FranjelisLuciano/Franjelis_Luciano_PLC4UNI/Tarea 6/4.Etiquetas/imagen.png

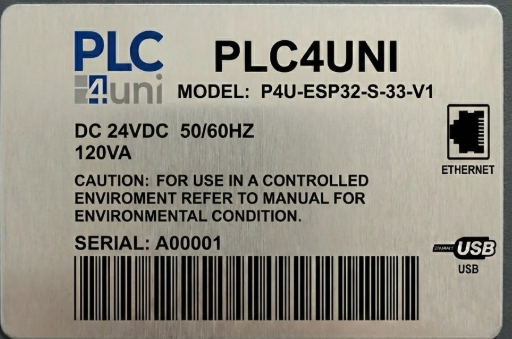
Tarea 6/4.Etiquetas/imagen.png
