FranjelisLuciano/Franjelis_Luciano_PLC4UNI/Tarea 6/4.Etiquetas/Informaciones de conexiones.png

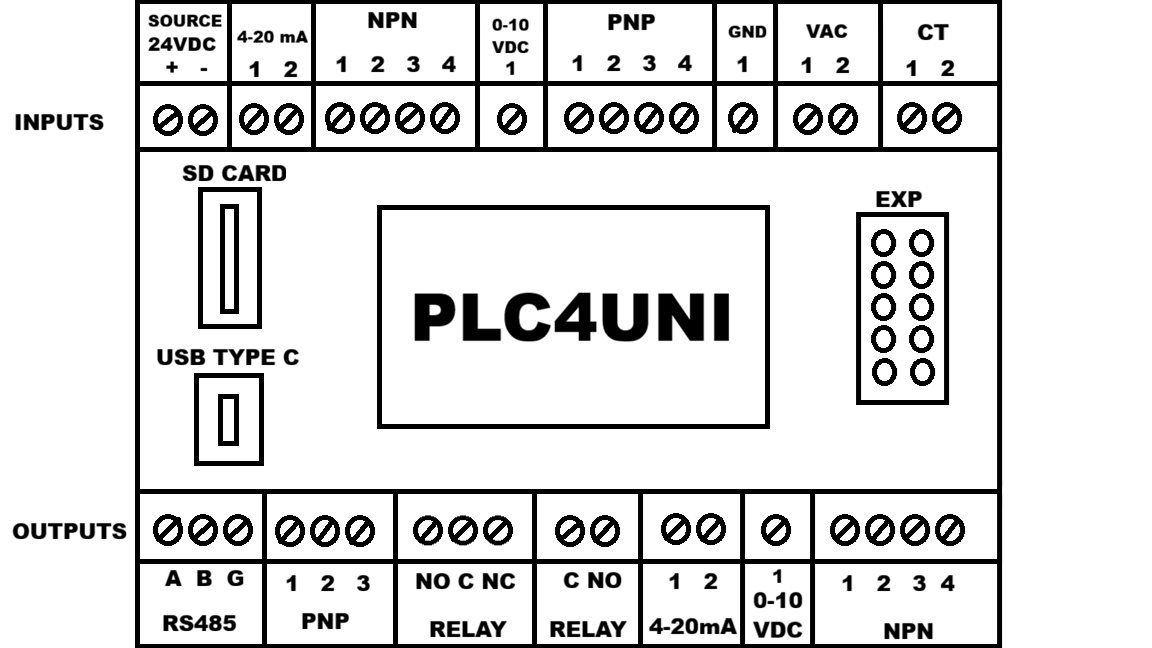
Tarea 6/4.Etiquetas/Informaciones de conexiones.png
