FranjelisLuciano/Franjelis_Luciano_PLC4UNI/Tarea 6/4.Etiquetas/Información de conexiones .jpg

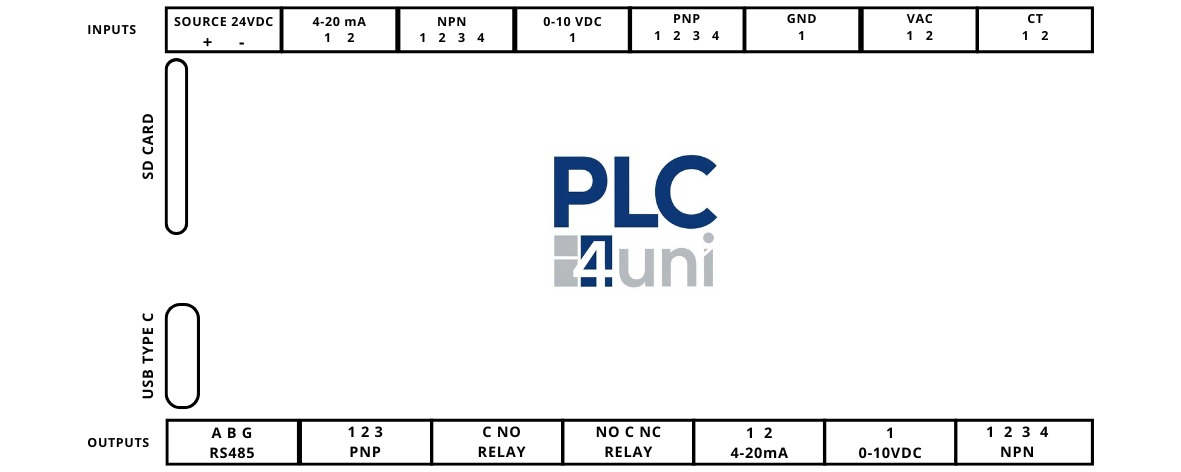
Tarea 6/4.Etiquetas/Información de conexiones .jpg
