FranjelisLuciano/Franjelis_Luciano_PLC4UNI/Tarea 6/Render/Render.png

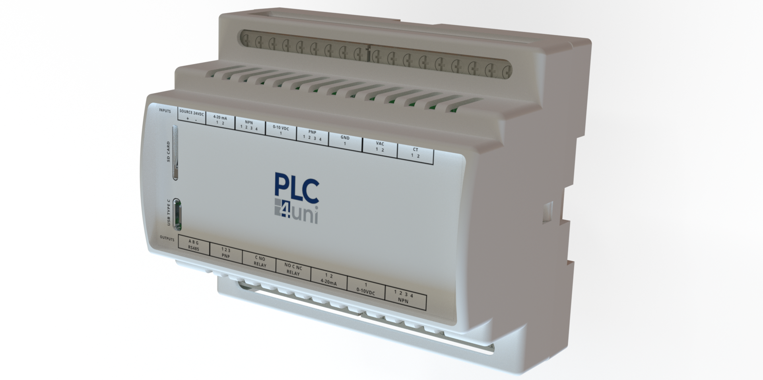
Tarea 6/Render/Render.png
