FranjelisLuciano/Franjelis_Luciano_PLC4UNI/Tarea 6/1.Ensamble en 3D/PLC4uni Ensamble.FCStd

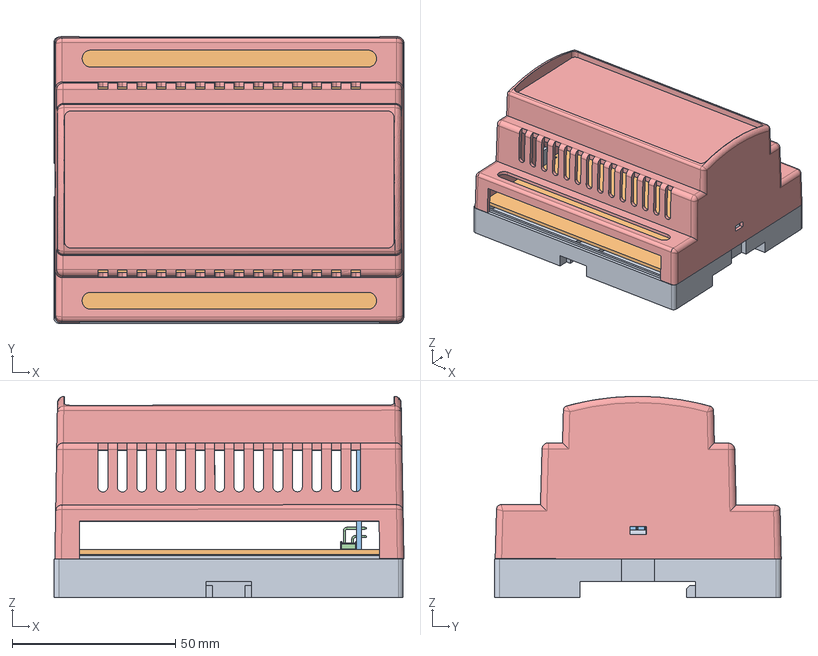
[picture p33: CAD file, 2025-12-03]
Tarea 6/1.Ensamble en 3D/PLC4uni Ensamble.FCStd
107.2 x 87.8 x 61.7 mm
PLC–4–UNI–209 Franjelis L._001
PLC4uni PCB_001
PLC4uni PCB_Vertical_001
2x5 male PIn Header Angle_001
PLC Part-1_001
