FranjelisLuciano/Franjelis_Luciano_PLC4UNI/Tarea 6/1.Ensamble en 3D/Ensamble PCB Vertical.STEP

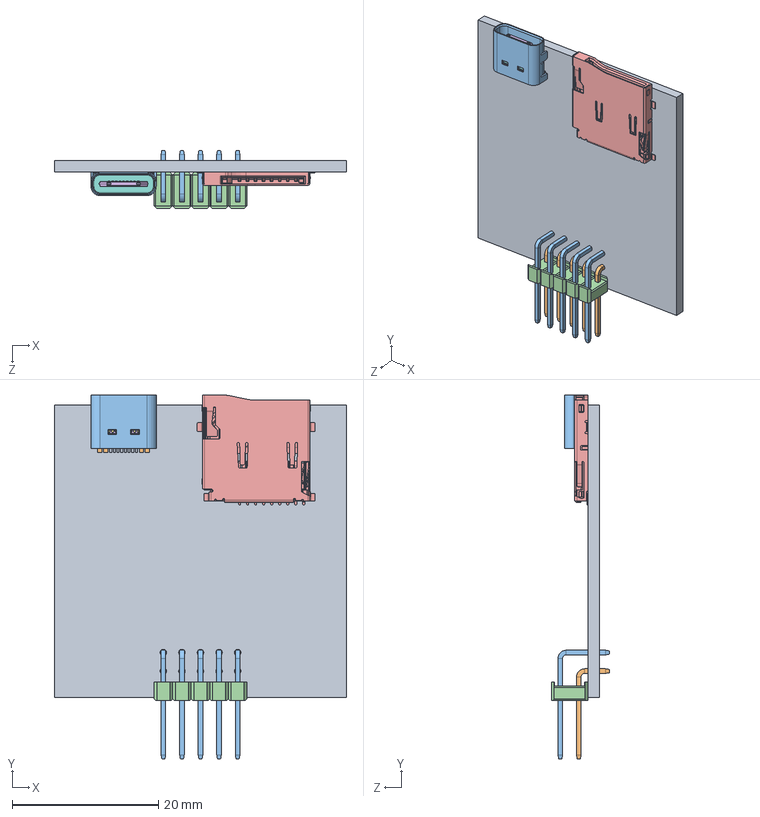
[picture p34: CAD file, 2025-12-03]
Tarea 6/1.Ensamble en 3D/Ensamble PCB Vertical.STEP
40.0 x 49.9 x 8.00 mm
PCB Vertical
2x5 Male Pin Header Angle
Same_Sky_MSD-4-A
USB Type C Port (SMD Type) (1)[1]
