FranjelisLuciano/Franjelis_Luciano_PLC4UNI/Tarea  4/PCB Vertical.DXF

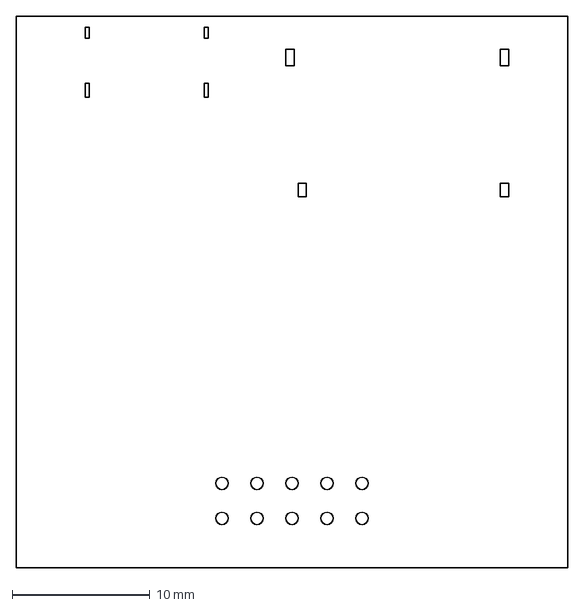
[picture p35: CAD file, 2025-12-03]
Tarea 4/PCB Vertical.DXF
40.0 x 40.0 mm
