FranjelisLuciano/Franjelis_Luciano_PLC4UNI/Tarea 3/DXF/Modelo 1/DXF de Freecad/PLC–4–UNI–209 Franjelis L.-Cuerpo001Fillet.dxf

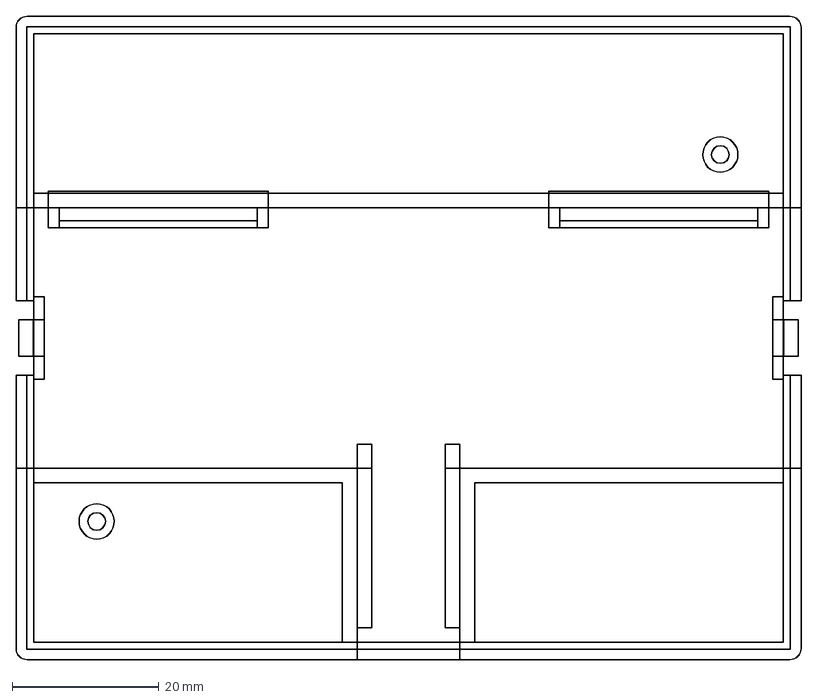
[picture p36: CAD file, 2025-10-09]
Tarea 3/DXF/Modelo 1/DXF de Freecad/PLC–4–UNI–209 Franjelis L.-Cuerpo001Fillet.dxf
107.0 x 87.7 mm
