FranjelisLuciano/Franjelis_Luciano_PLC4UNI/Tarea 6/2.Conector USB y SD Card/Same_Sky_MSD-4-A.step

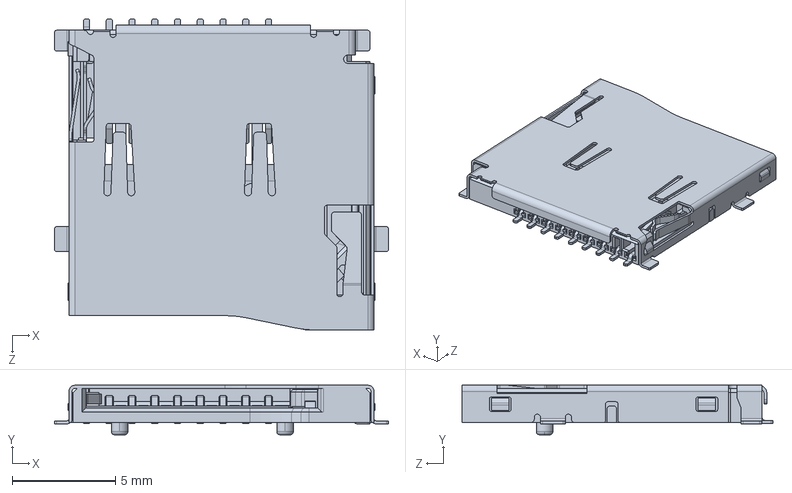
[picture p37: CAD file, 2025-12-03]
Tarea 6/2.Conector USB y SD Card/Same_Sky_MSD-4-A.step
16.1 x 2.40 x 15.0 mm
