FranjelisLuciano/Franjelis_Luciano_PLC4UNI/Tarea2_/Videos explicativos/Diseños 2.2/Diseños en Freecad/PLC–4–UNI–208 Franjelis L..FCStd

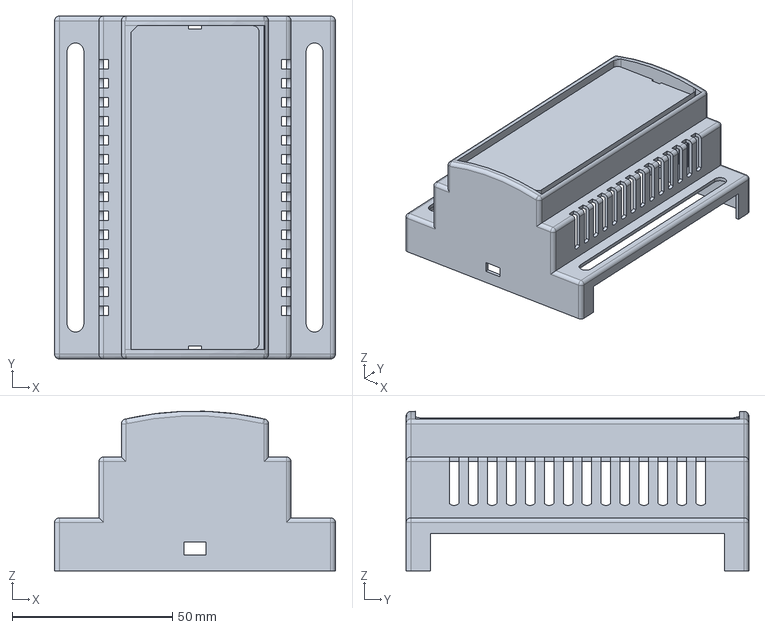
[picture p38: CAD file, 2025-10-02]
Tarea2_/Videos explicativos/Diseños 2.2/Diseños en Freecad/PLC–4–UNI–208 Franjelis L..FCStd
87.7 x 107.0 x 49.8 mm
