FranjelisLuciano/Franjelis_Luciano_PLC4UNI/Tarea  4/2x5 Male Pin Header Angle.STEP

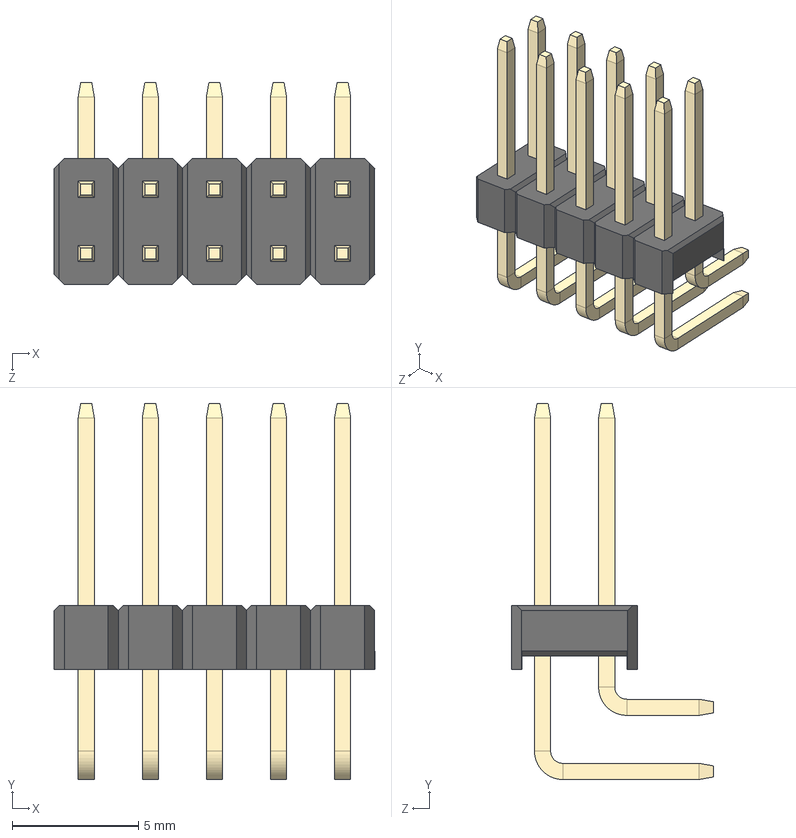
[picture p39: CAD file, 2025-12-03]
Tarea 4/2x5 Male Pin Header Angle.STEP
12.7 x 14.9 x 8.00 mm
