FranjelisLuciano/Franjelis_Luciano_PLC4UNI/Tarea 3/DXF/Modelo 1/DXF de Freecad/PLC–4–UNI–208 Franjelis L.-Body001Pad007.dxf

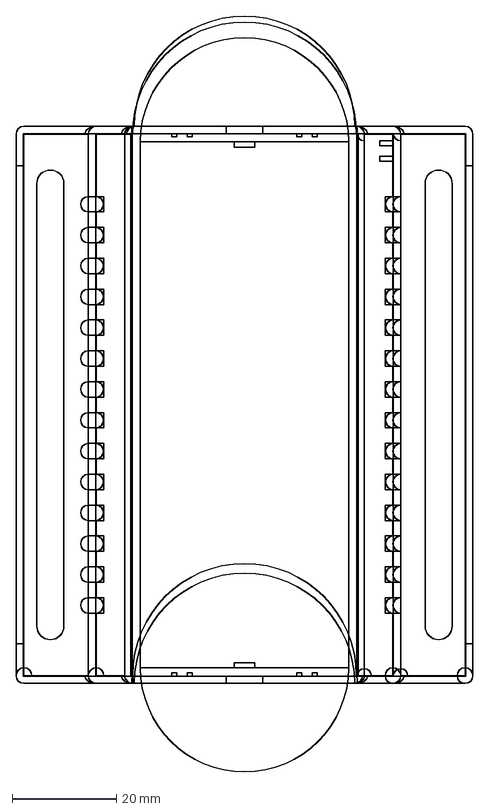
[picture p40: CAD file, 2025-10-09]
Tarea 3/DXF/Modelo 1/DXF de Freecad/PLC–4–UNI–208 Franjelis L.-Body001Pad007.dxf
87.7 x 145.2 mm
