FranjelisLuciano/Franjelis_Luciano_PLC4UNI/Tarea 6/2.Conector USB y SD Card/USB Type C Port (SMD Type) (1)[1].STEP

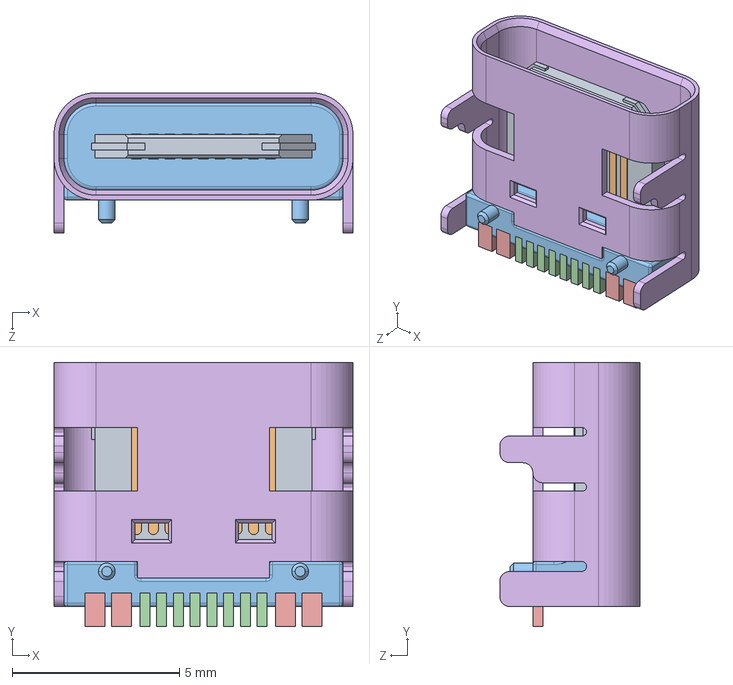
[picture p41: CAD file, 2025-12-03]
Tarea 6/2.Conector USB y SD Card/USB Type C Port (SMD Type) (1)[1].STEP
8.94 x 7.90 x 4.20 mm
