FranjelisLuciano/Franjelis_Luciano_PLC4UNI/Tarea2_/Videos explicativos/Diseños 2.2/Diseños en Freecad/PLC–4–UNI–209 Franjelis L..FCStd

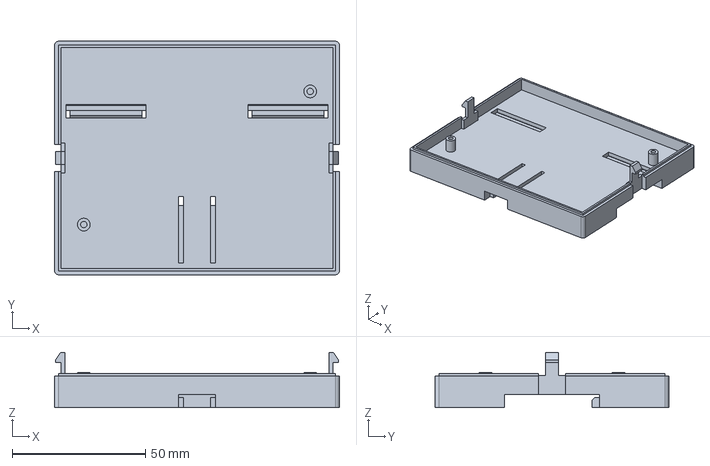
[picture p42: CAD file, 2025-10-02]
Tarea2_/Videos explicativos/Diseños 2.2/Diseños en Freecad/PLC–4–UNI–209 Franjelis L..FCStd
107.0 x 87.7 x 20.8 mm
