FranjelisLuciano/Franjelis_Luciano_PLC4UNI/DIAGRAMAS DE BORRADOR/Proyectoplc4unidiagramas/Proyectoplc4unidiagramas/OUT-NPN-1.kicad_sch

## KiCad design DIAGRAMAS DE BORRADOR/Proyectoplc4unidiagramas/Proyectoplc4unidiagramas/OUT-NPN-1.kicad_sch (2025-11-09)

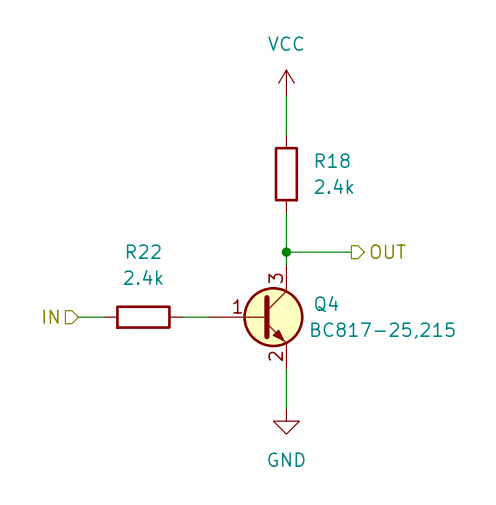
[picture p65: schematic OUT-NPN-1.kicad_sch]

Parts:
Q4: BFN26; SOT-23; Part number BC817-25,215
R18, R22: 2.4k; R_0603_1608Metric

Connections:
GND: Q4.2 (E)
IN: R22.1
unnamed: Q4.1 (B), R22.2
OUT: Q4.3 (C), R18.1
VCC: R18.2
