FranjelisLuciano/Franjelis_Luciano_PLC4UNI/DIAGRAMAS DE BORRADOR/Proyectoplc4unidiagramas/Proyectoplc4unidiagramas/OUT-RELAY-1.kicad_sch

## KiCad design DIAGRAMAS DE BORRADOR/Proyectoplc4unidiagramas/Proyectoplc4unidiagramas/OUT-RELAY-1.kicad_sch (2025-11-09)

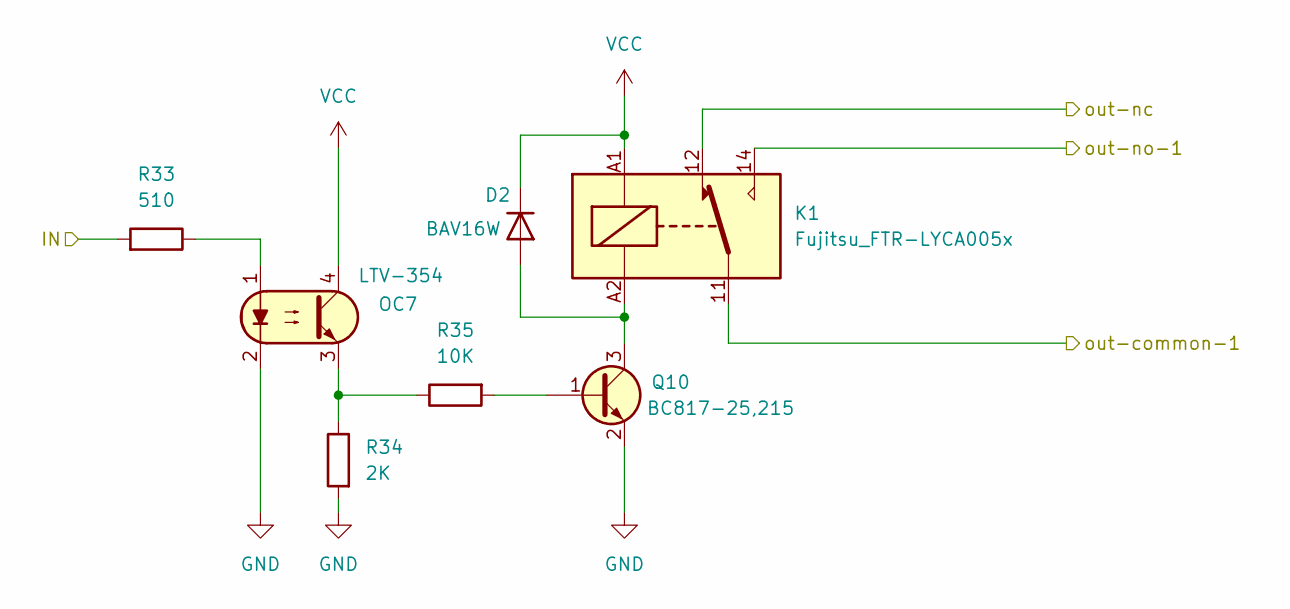
[picture p66: schematic OUT-RELAY-1.kicad_sch]

Parts:
D2: 1N4148WT; D_SOD-523; Part number BAV16W
K1: Fujitsu_FTR-LYCA005x; Relay_SPDT_Fujitsu_FTR-LYCA005x_FormC_Vertical
OC7: FOD817S; SMDIP-4_W9.53mm; Part Number LTV-354
Q10: BFN26; SOT-23; Part number BC817-25,215
R33: 510; R_0603_1608Metric
R34: 2K; R_0603_1608Metric
R35: 10K; R_0603_1608Metric

Connections:
GND: OC7.2, Q10.2 (E), R34.1
IN: R33.1
unnamed: D2.2 (A), K1.A2, Q10.3 (C)
unnamed: OC7.1, R33.2
unnamed: OC7.3, R34.2, R35.2
unnamed: Q10.1 (B), R35.1
VCC: D2.1 (K), K1.A1, OC7.4
out-common-1: K1.11
out-nc: K1.12
out-no-1: K1.14
