FranjelisLuciano/Franjelis_Luciano_PLC4UNI/DIAGRAMAS DE BORRADOR/Proyectoplc4unidiagramas/Proyectoplc4unidiagramas/OUT-RELAY-2.kicad_sch

## KiCad design DIAGRAMAS DE BORRADOR/Proyectoplc4unidiagramas/Proyectoplc4unidiagramas/OUT-RELAY-2.kicad_sch (2025-11-09)

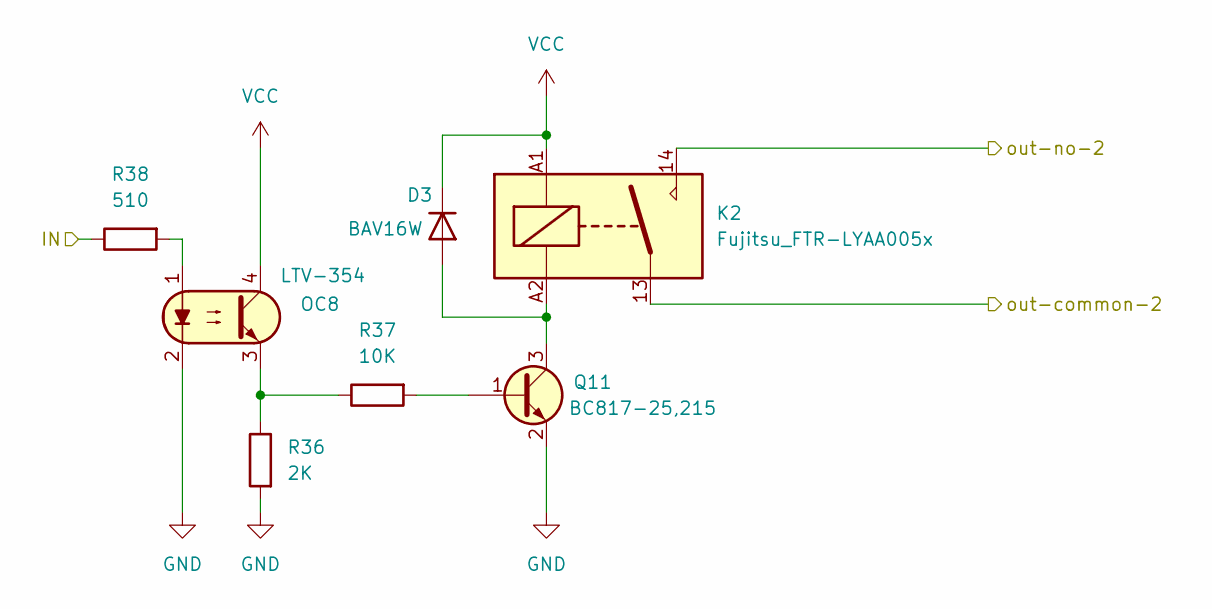
[picture p67: schematic OUT-RELAY-2.kicad_sch]

Parts:
D3: 1N4148WT; D_SOD-523; Part number BAV16W
K2: Fujitsu_FTR-LYAA005x; Relay_SPST-NO_Fujitsu_FTR-LYAA005x_FormA_Vertical
OC8: FOD817S; SMDIP-4_W9.53mm; Part Number LTV-354
Q11: BFN26; SOT-23; Part number BC817-25,215
R36: 2K; R_0603_1608Metric
R37: 10K; R_0603_1608Metric
R38: 510; R_0603_1608Metric

Connections:
GND: OC8.2, Q11.2 (E), R36.1
IN: R38.2
unnamed: D3.2 (A), K2.A2, Q11.3 (C)
unnamed: OC8.1, R38.1
unnamed: OC8.3, R36.2, R37.2
unnamed: Q11.1 (B), R37.1
VCC: D3.1 (K), K2.A1, OC8.4
out-common-2: K2.13
out-no-2: K2.14
