FranjelisLuciano/Franjelis_Luciano_PLC4UNI/DIAGRAMAS DE BORRADOR/Proyectoplc4unidiagramas/Proyectoplc4unidiagramas/Proyectoplc4unidiagramas.kicad_sch

## KiCad design DIAGRAMAS DE BORRADOR/Proyectoplc4unidiagramas/Proyectoplc4unidiagramas/Proyectoplc4unidiagramas.kicad_sch (2025-11-09)

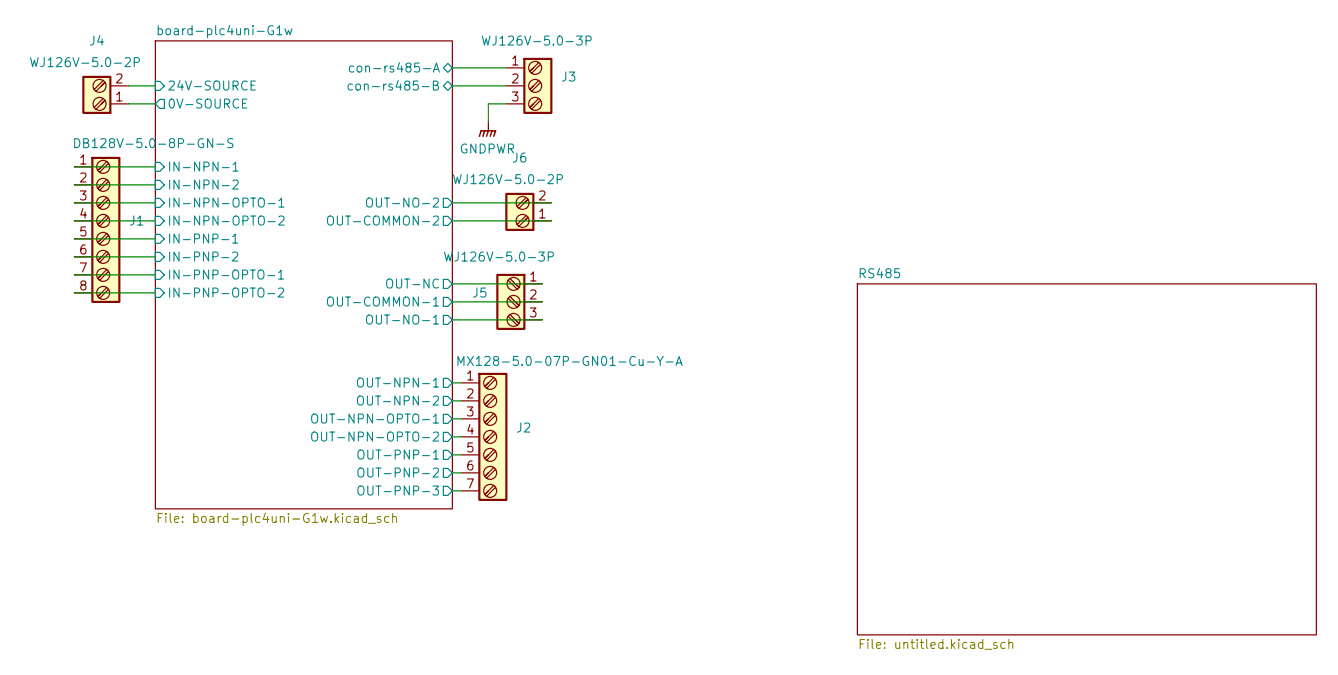
[picture p68: schematic Proyectoplc4unidiagramas.kicad_sch]

Parts:
J1: Screw_Terminal_8_P5.00mm; TerminalBlock_Phoenix_PT-1,5-8-5.0-H_1x08_P5.00mm_Horizontal; Part number DB128V-5.0-8P-GN-S
J2: Screw_Terminal_7_P5.00mm; TerminalBlock_Phoenix_PT-1,5-7-5.0-H_1x07_P5.00mm_Horizontal; Part number MX128-5.0-07P-GN01-Cu-Y-A
J3, J5: Screw_Terminal_3_P5.00mm; TerminalBlock_Phoenix_PT-1,5-3-5.0-H_1x03_P5.00mm_Horizontal; Part number WJ126V-5.0-3P
J4, J6: Screw_Terminal_2_P5.00mm; TerminalBlock_Phoenix_PT-1,5-2-5.0-H_1x02_P5.00mm_Horizontal; Part number WJ126V-5.0-2P

Connections:
0V-SOURCE: J4.1
24V-SOURCE: J4.2
GNDPWR: J3.3
IN-NPN-1: J1.1
IN-NPN-2: J1.2
IN-NPN-OPTO-1: J1.3
IN-NPN-OPTO-2: J1.4
IN-PNP-1: J1.5
IN-PNP-2: J1.6
IN-PNP-OPTO-1: J1.7
IN-PNP-OPTO-2: J1.8
OUT-COMMON-1: J5.2
OUT-COMMON-2: J6.1
OUT-NC: J5.1
OUT-NO-1: J5.3
OUT-NO-2: J6.2
OUT-NPN-1: J2.1
OUT-NPN-2: J2.2
OUT-NPN-OPTO-1: J2.3
OUT-NPN-OPTO-2: J2.4
OUT-PNP-1: J2.5
OUT-PNP-2: J2.6
OUT-PNP-3: J2.7
con-rs485-A: J3.1
con-rs485-B: J3.2
