FranjelisLuciano/Franjelis_Luciano_PLC4UNI/DIAGRAMAS DE BORRADOR/Proyectoplc4unidiagramas/Proyectoplc4unidiagramas/input-npn-opto.kicad_sch

## KiCad design DIAGRAMAS DE BORRADOR/Proyectoplc4unidiagramas/Proyectoplc4unidiagramas/input-npn-opto.kicad_sch (2025-11-09)

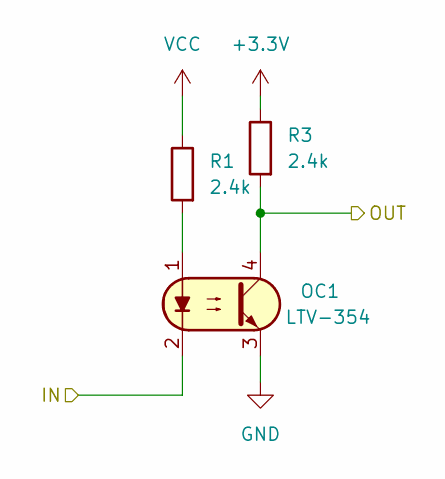
[picture p69: schematic input-npn-opto.kicad_sch]

Parts:
OC1: FOD817S; SMDIP-4_W9.53mm; Part Number LTV-354
R1, R3: 2.4k; R_0603_1608Metric

Connections:
+3.3V: R3.2
GND: OC1.3
IN: OC1.2
unnamed: OC1.1, R1.1
OUT: OC1.4, R3.1
VCC: R1.2
