FranjelisLuciano/Franjelis_Luciano_PLC4UNI/DIAGRAMAS DE BORRADOR/Proyectoplc4unidiagramas/Proyectoplc4unidiagramas/input-pnp-opto.kicad_sch

## KiCad design DIAGRAMAS DE BORRADOR/Proyectoplc4unidiagramas/Proyectoplc4unidiagramas/input-pnp-opto.kicad_sch (2025-11-09)

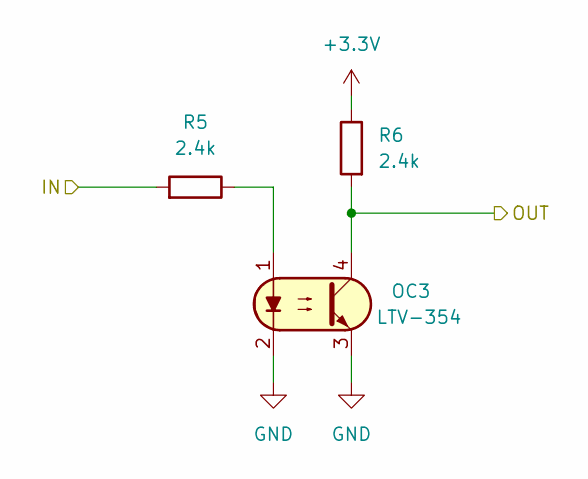
[picture p71: schematic input-pnp-opto.kicad_sch]

Parts:
OC3: FOD817S; SMDIP-4_W9.53mm; Part Number LTV-354
R5, R6: 2.4k; R_0603_1608Metric

Connections:
+3.3V: R6.2
GND: OC3.2, OC3.3
IN: R5.1
unnamed: OC3.1, R5.2
OUT: OC3.4, R6.1
