FranjelisLuciano/Franjelis_Luciano_PLC4UNI/DIAGRAMAS DE BORRADOR/Proyectoplc4unidiagramas/Proyectoplc4unidiagramas/input-pnp.kicad_sch

## KiCad design DIAGRAMAS DE BORRADOR/Proyectoplc4unidiagramas/Proyectoplc4unidiagramas/input-pnp.kicad_sch (2025-11-09)

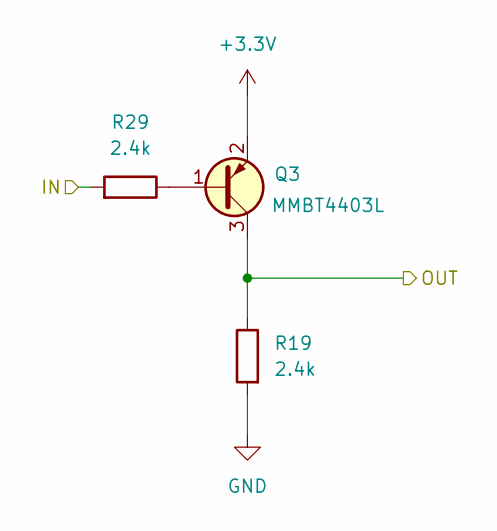
[picture p72: schematic input-pnp.kicad_sch]

Parts:
Q3: 2SA2018; SOT-416; Part number MMBT4403L
R19, R29: 2.4k; R_0603_1608Metric

Connections:
+3.3V: Q3.2 (E)
GND: R19.1
IN: R29.1
unnamed: Q3.1 (B), R29.2
OUT: Q3.3 (C), R19.2
