FranjelisLuciano/Franjelis_Luciano_PLC4UNI/DIAGRAMAS DE BORRADOR/Proyectoplc4unidiagramas/Proyectoplc4unidiagramas/source protection.kicad_sch

## KiCad design DIAGRAMAS DE BORRADOR/Proyectoplc4unidiagramas/Proyectoplc4unidiagramas/source protection.kicad_sch (2025-11-09)

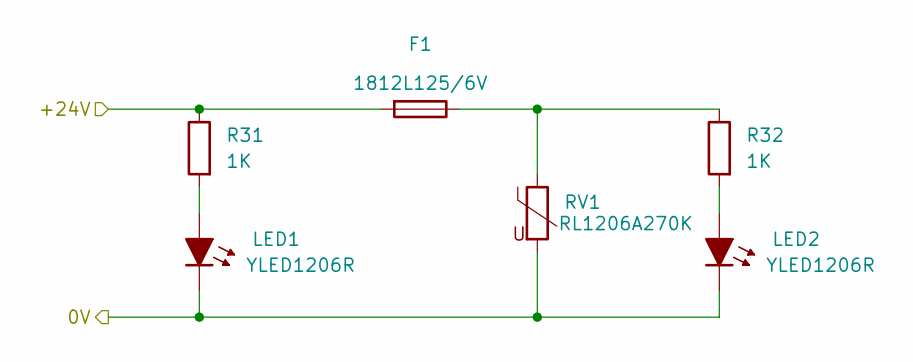
[picture p75: schematic source protection.kicad_sch]

Parts:
F1: Fuse; Fuse_Blade_Mini_directSolder; Part number 1812L125/6V
LED1, LED2: LED_1.8mm_SMD; LED_1.8mm_GullWing; Part number YLED1206R
R31, R32: 1K; R_0603_1608Metric
RV1: Varistor; RV_Disc_D7mm_W5.1mm_P5mm; Part number RL1206A270K

Connections:
0V: LED1.1 (K), LED2.1 (K), RV1.2
+24V: F1.2, R31.2
unnamed: F1.1, R32.2, RV1.1
unnamed: LED1.2 (A), R31.1
unnamed: LED2.2 (A), R32.1
