FranjelisLuciano/Franjelis_Luciano_PLC4UNI/Tarea 3/DXF/Modelo 1/Modelo 1.kicad_sch

## KiCad design Tarea 3/DXF/Modelo 1/Modelo 1.kicad_sch (2025-10-09)

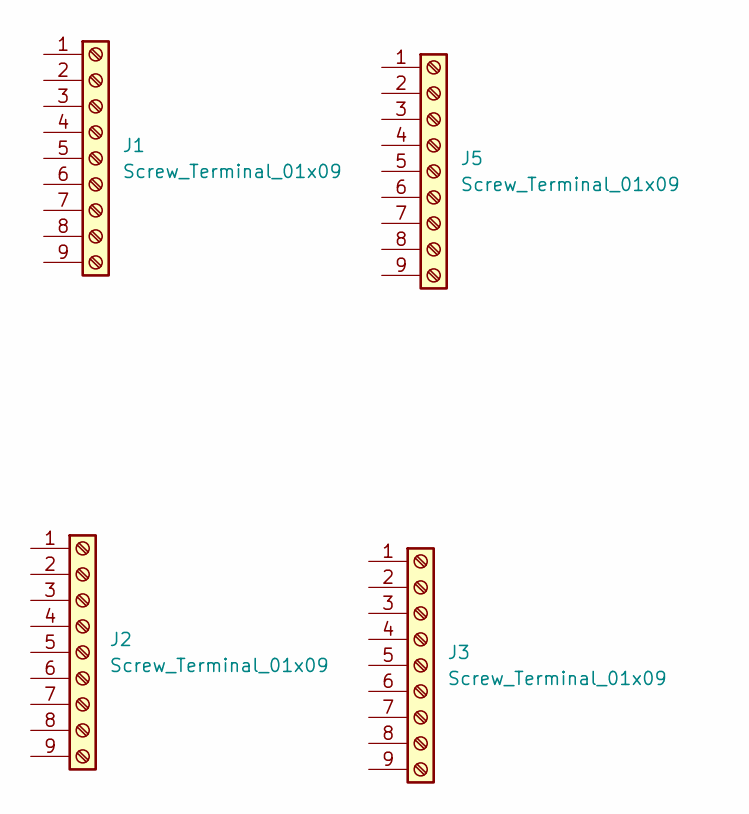
[picture p77: schematic Modelo 1.kicad_sch]

Parts:
J1, J2, J3, J5: Screw_Terminal_01x09; TerminalBlock_Phoenix_PT-1,5-9-5.0-H_1x09_P5.00mm_Horizontal
