FranjelisLuciano/Franjelis_Luciano_PLC4UNI/(commit log)

2025-09-19 Create DOC - Plantilla SRS ERS Norma IEEE-830 STD.docx
    Este es el primer documento, concerniente a la Tarea 1, es el documento que sienta las bases para la creación del PLC
2025-09-25 Add files via upload
    Aqui está la tarea 2, dentro se encuentran el video de explicación, y los diseños.
2025-09-25 Add files via upload
    Documento de creación de un-PLC, editado
2025-10-02 Add files via upload
    Se han añadido los puertos correspondientes y demás acerca de la entrada y salidas que se han especificado en clases.
2025-10-02 Add files via upload
    Se han añadido los diferentes diseños correspondiente a la parte 2 de la tarea 2.
    [PLC–4–UNI–208 Franjelis L..FCStd, PLC–4–UNI–209 Franjelis L..FCStd]
2025-10-08 Add files via upload
    Se han establecido los pines de entradas y salidas, especificados correctamente.
2025-10-09 Tarea 3
    Aqui esta solamente el dxf, falta la investigación que ya he realizado y los esquemáticos, que están en proceso.
2025-10-09 Add files via upload
    Aqui esta el DXF normal, sin zip.
    [Modelo 1.kicad_pcb, Modelo 1.kicad_sch]
2025-10-09 DXF de Freecad
    He subido el DXF de freecad, el otro dxf es el que está limpio en Kicad.
    [PLC–4–UNI–208 Franjelis L.-Body001Pad007.dxf, PLC–4–UNI–209 Franjelis L.-Cuerpo001Fillet.dxf]
2025-10-23 Actualización
    Esta es la actualización, se ha mejorado la entrada a Relay.
2025-11-09 Create Diagramas PLC4UNI (borrador)
    En este apartado están todos los diagramas que tengo hasta el momento.
2025-12-03 Add files via upload
    Aqui está la tarea 4, incluye: Posición en el PCB principal de los conectores
    Posición en el PCB Horizontal del conector USB y uSD y del conector de conexión con la pcb principal
    Dimensiones del PCB
    Realizar el feature para colocar la pieza en la CNC
    Realizar el código G para el CAM
    [2x5 Male Pin Header Angle.STEP, Ensamble PCB Vertical.STEP, PCB Vertical.DXF, PLC4uni Ensamble.FCStd, Same_Sky_MSD-4-A.step, USB Type C Port (SMD Type) (1)[1].STEP]
2025-12-03 Delete USB Type C Port (SMD Type) (1)[1].STEP
    Se ha subido mal
    [USB Type C Port (SMD Type) (1)[1].STEP]
2025-12-03 Delete 2x5 Male Pin Header Angle.STEP
    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
    [2x5 Male Pin Header Angle.STEP]
2025-12-03 Add files via upload
    Aqui esta la tarea 4, incluye: Posición en el PCB principal de los conectores
    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
    [2x5 Male Pin Header Angle.STEP, Ensamble PCB Vertical.STEP, PCB Vertical.DXF, PLC4uni Ensamble.FCStd, Same_Sky_MSD-4-A.step, USB Type C Port (SMD Type) (1)[1].STEP]
2025-12-04 Add files via upload
    Aqui está la tarea 5, contiene el manual para PLC4UNI
2025-12-11 Add files via upload
    Aqui está la tarea 6.
    [Ensamble PCB Vertical.STEP, PLC4uni Ensamble.FCStd, Same_Sky_MSD-4-A.step, USB Type C Port (SMD Type) (1)[1].STEP]
